vad7/Temperature_Display/Docs/Button 6x6 4P.png

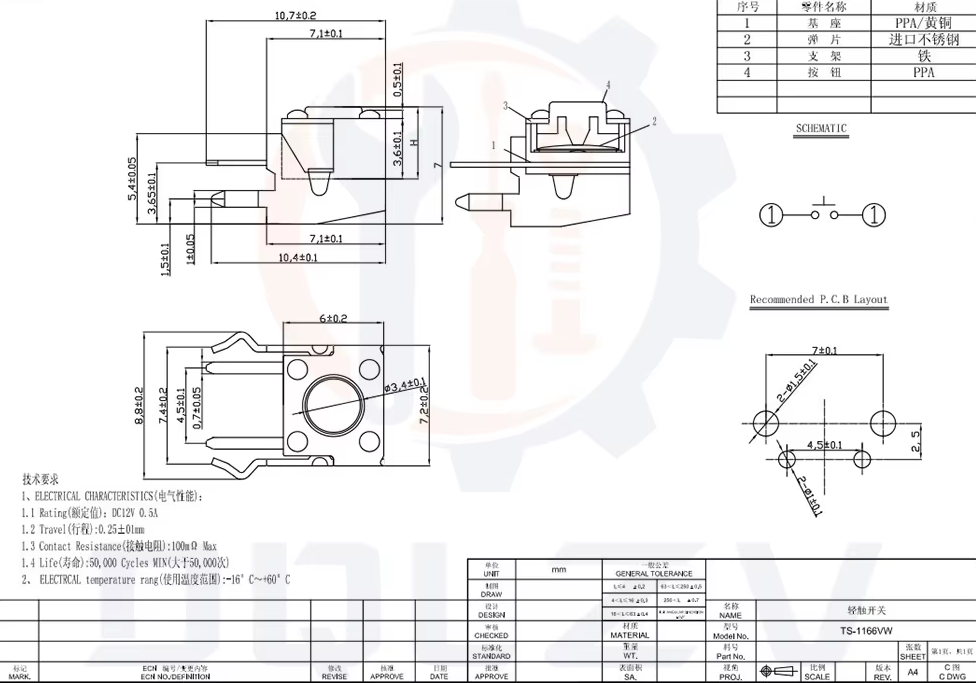
Docs/Button 6x6 4P.png
