vad7/Temperature_Display/Docs/Perfboard_20x80.png

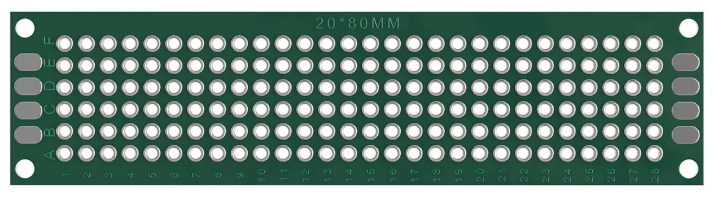
Docs/Perfboard_20x80.png
