vad7/Temperature_Display/Docs/Pro Mini 328 pinout.png

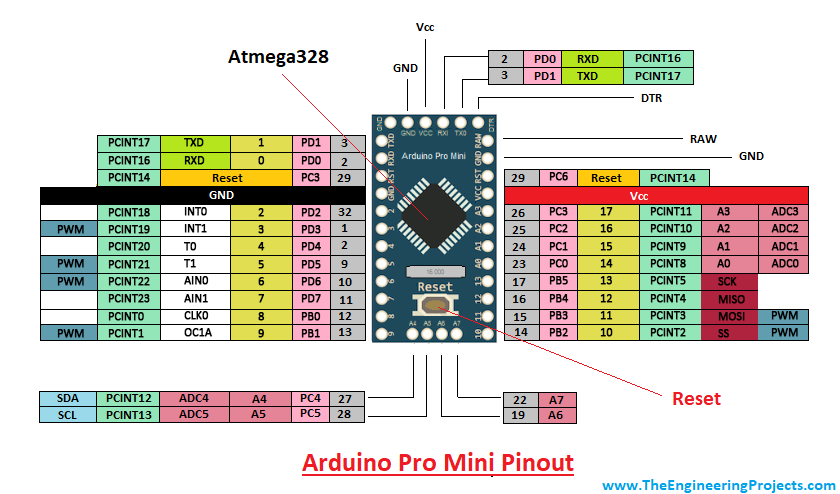
Docs/Pro Mini 328 pinout.png
