vad7/Temperature_Display/Docs/Pro Mini 328-2.png

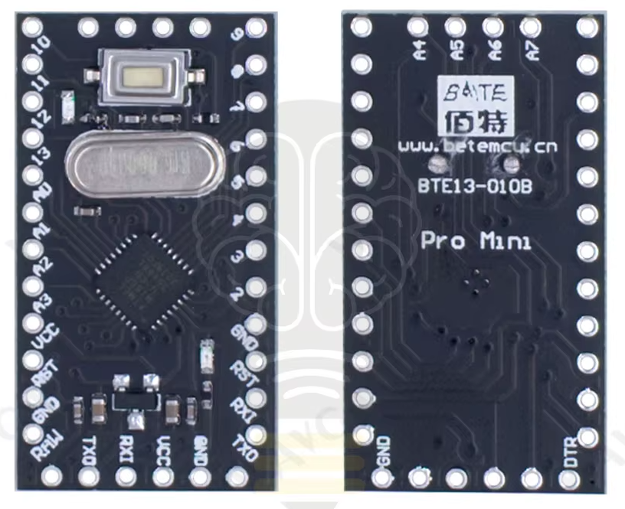
Docs/Pro Mini 328-2.png
