vad7/Temperature_Display/Docs/Pro Mini 328-3.png

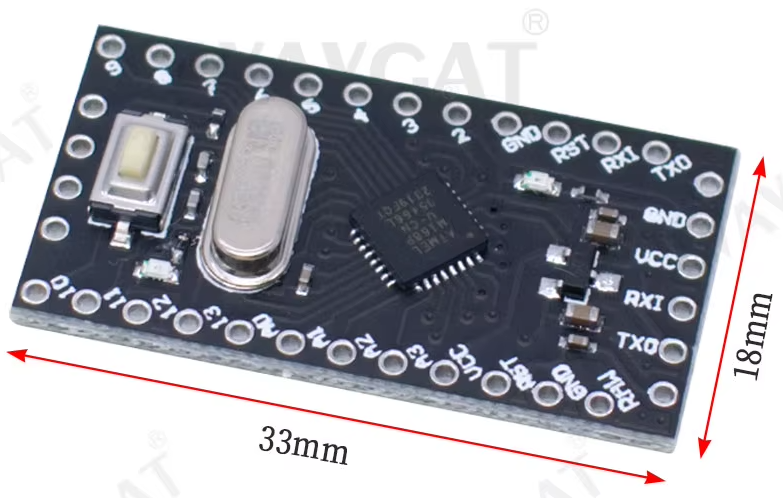
Docs/Pro Mini 328-3.png
