vad7/Temperature_Display/Docs/Pro Mini 328.png

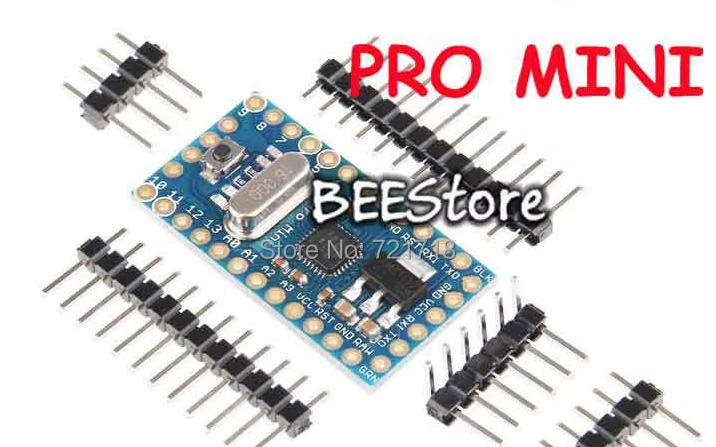
Docs/Pro Mini 328.png
