vad7/Temperature_Display/Docs/TFT1.77 128x160 ST7735S.png

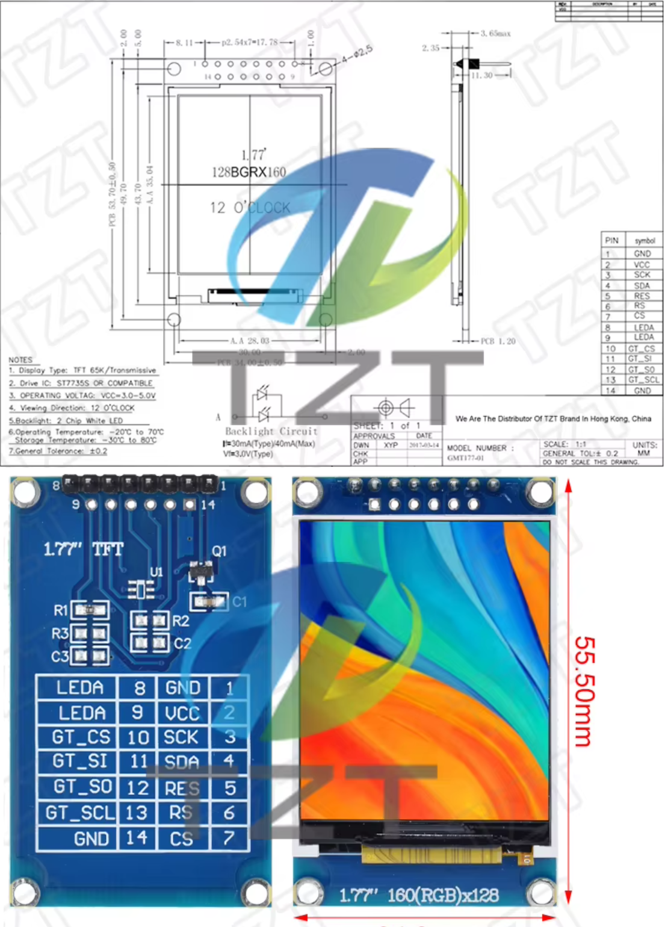
Docs/TFT1.77 128x160 ST7735S.png
