vad7/Temperature_Display/Build/enclosure/TempDisplay_tft24_assembly.step

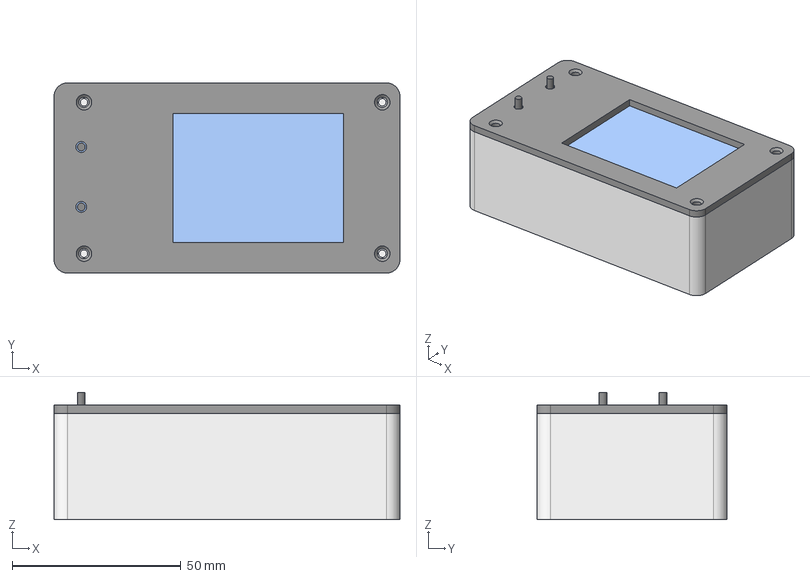
[picture p17: CAD file, 2026-11-03]
Build/enclosure/TempDisplay_tft24_assembly.step
102.6 x 56.4 x 37.7 mm
lid
bar_hlk_nano
ear_hlk_2
ear_promini_1
ear_promini_2
tft_glass
tft_pcb
perfboard
perfboard_c1
hlk
promini
button_1
button_2
button_1_plunger
button_2_plunger
