vad7/Temperature_Display/Build/enclosure/TempDisplay_tft18_assembly.step

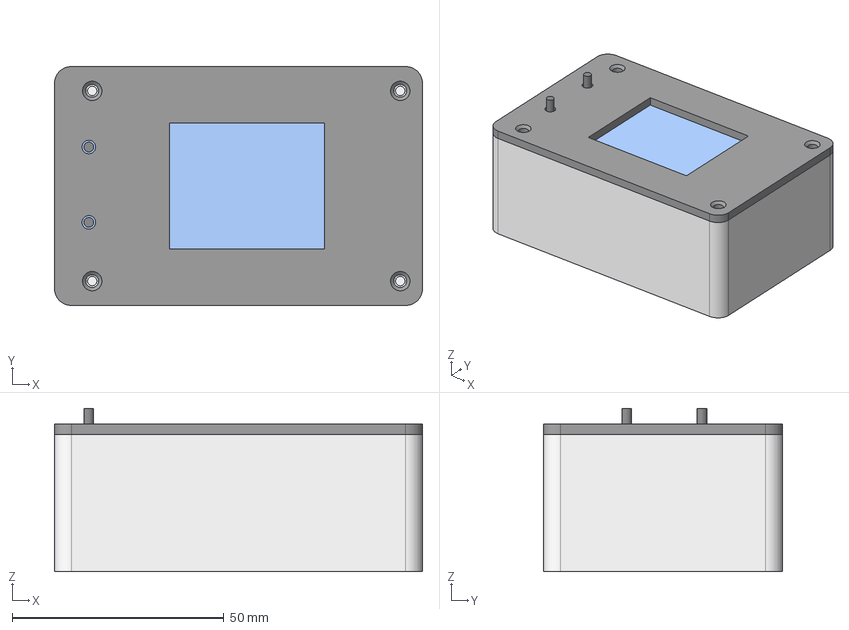
[picture p18: CAD file, 2026-11-03]
Build/enclosure/TempDisplay_tft18_assembly.step
86.8 x 56.4 x 38.5 mm
lid
bar_hlk_nano
ear_hlk_2
ear_promini_1
ear_promini_2
tft_glass
tft_pcb
perfboard
perfboard_c1
hlk
promini
button_1
button_2
button_1_plunger
button_2_plunger
