vad7/Temperature_Display/Build/enclosure/TempDisplay_tft177_body.stl

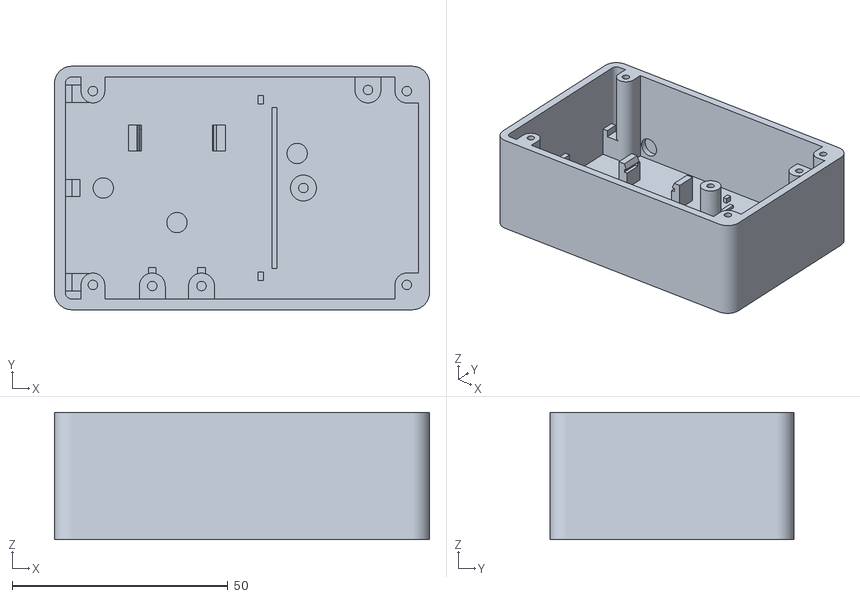
[picture p20: CAD file, 2026-11-03]
Build/enclosure/TempDisplay_tft177_body.stl
86.8 x 56.4 x 29.5
