vad7/Temperature_Display/Build/enclosure/TempDisplay_tft177_lid.stl

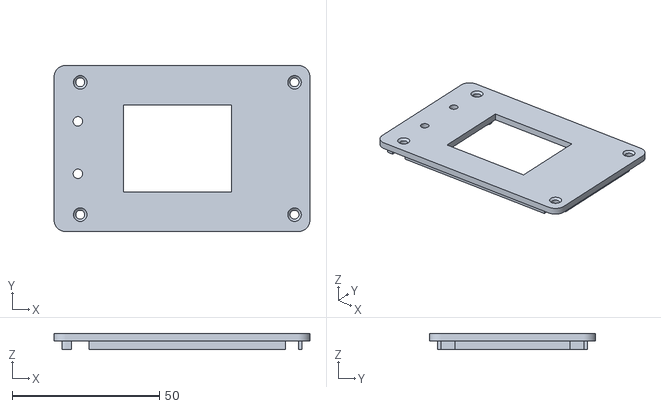
[picture p21: CAD file, 2026-11-03]
Build/enclosure/TempDisplay_tft177_lid.stl
86.8 x 56.4 x 5.50
