vad7/Temperature_Display/Build/enclosure/TempDisplay_tft24_lid.stl

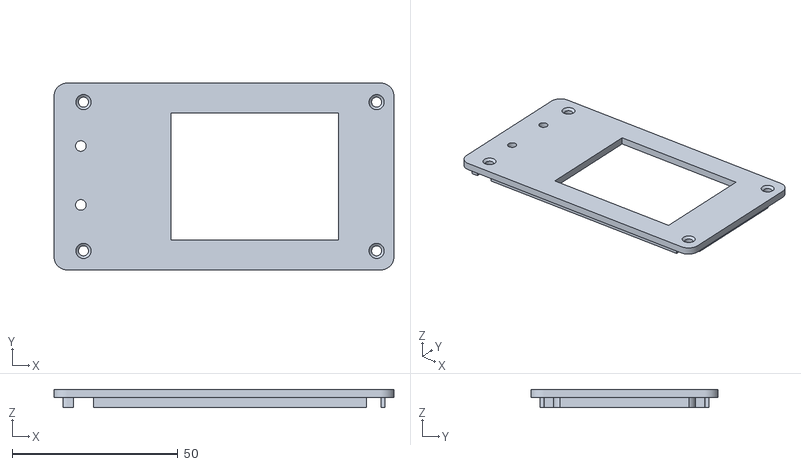
[picture p22: CAD file, 2026-11-03]
Build/enclosure/TempDisplay_tft24_lid.stl
102.6 x 56.4 x 5.50
