vad7/Temperature_Display/Build/enclosure/TempDisplay_tft18_lid.stl

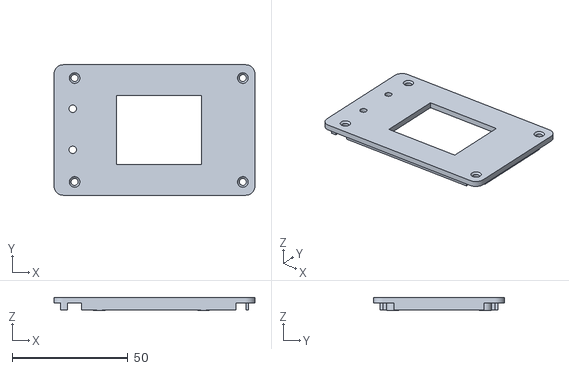
[picture p23: CAD file, 2026-11-03]
Build/enclosure/TempDisplay_tft18_lid.stl
86.8 x 56.4 x 5.65
