vad7/Temperature_Display/Build/enclosure/TempDisplay_tft24_body.stl

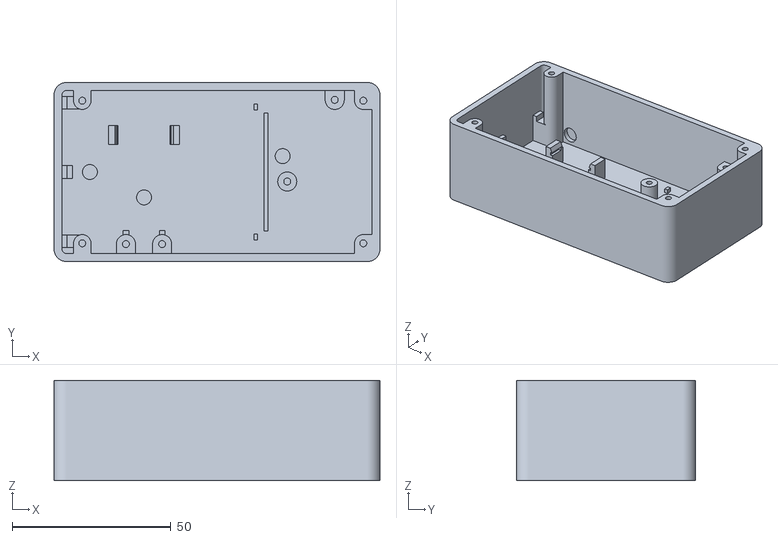
[picture p24: CAD file, 2026-11-03]
Build/enclosure/TempDisplay_tft24_body.stl
102.6 x 56.4 x 31.5
