vad7/Temperature_Display/Build/enclosure/TempDisplay_tft18_body.stl

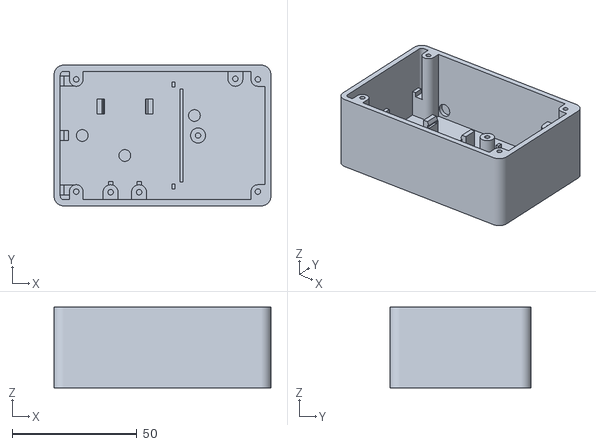
[picture p25: CAD file, 2026-11-03]
Build/enclosure/TempDisplay_tft18_body.stl
86.8 x 56.4 x 32.3
