vad7/Temperature_Display/Build/enclosure/TempDisplay_tft24_ears.stl

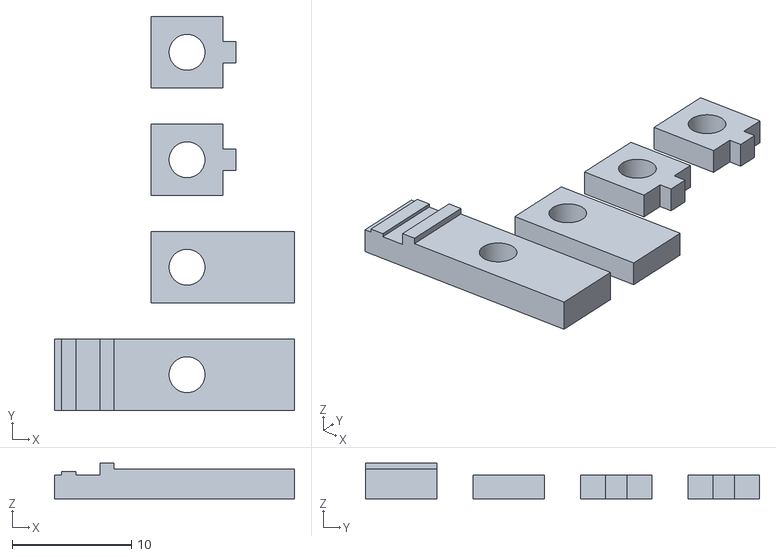
[picture p26: CAD file, 2026-10-23]
Build/enclosure/TempDisplay_tft24_ears.stl
20.1 x 33.0 x 3.00
