vad7/Temperature_Display/(list of files, cad)

Other CAD files:
Build/enclosure/TempDisplay_tft18_ears.stl
Build/enclosure/TempDisplay_tft177_ears.stl
