vad7/Temperature_Display/Build/enclosure/TempDisplay_tft18_preview.png

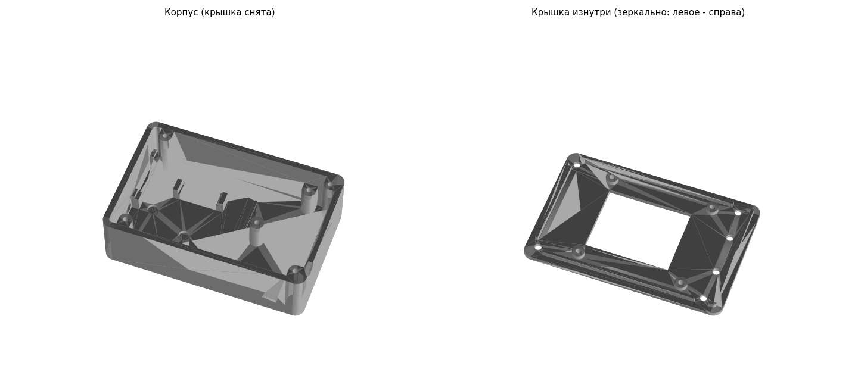
Build/enclosure/TempDisplay_tft18_preview.png
