vad7/Temperature_Display/Build/enclosure/TempDisplay_tft24_layout.png

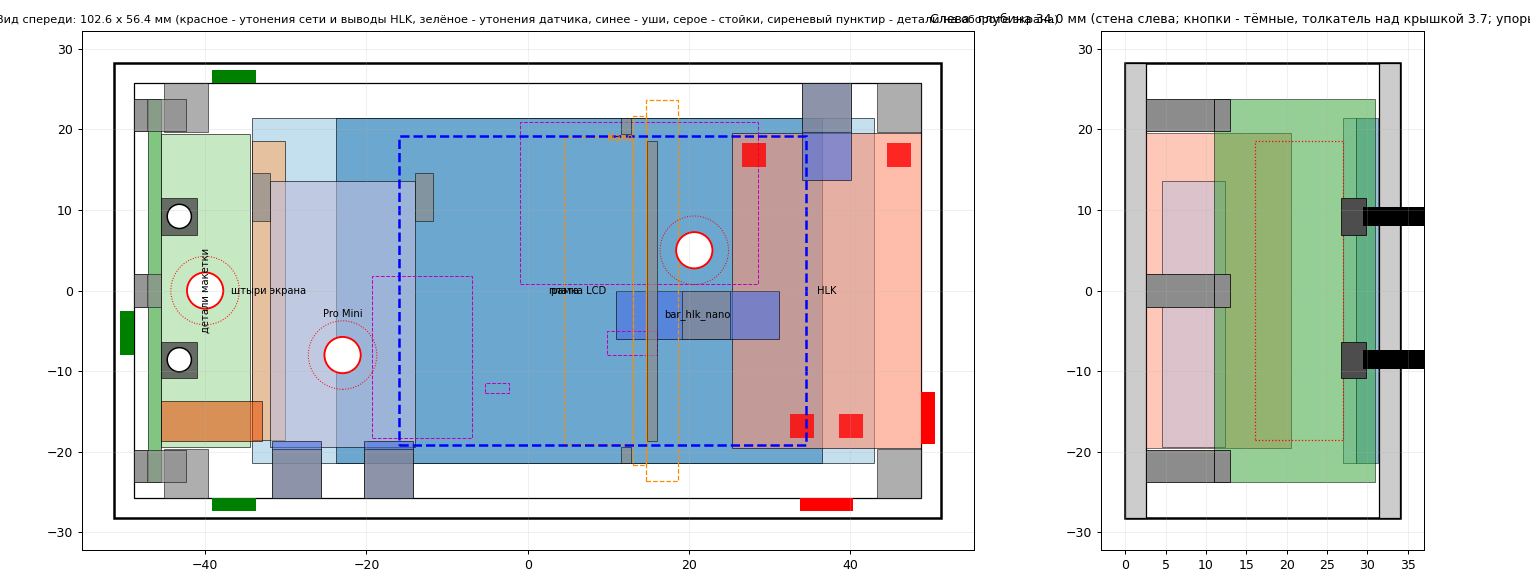
Build/enclosure/TempDisplay_tft24_layout.png
