vad7/Temperature_Display/Docs/3D Print settings.png

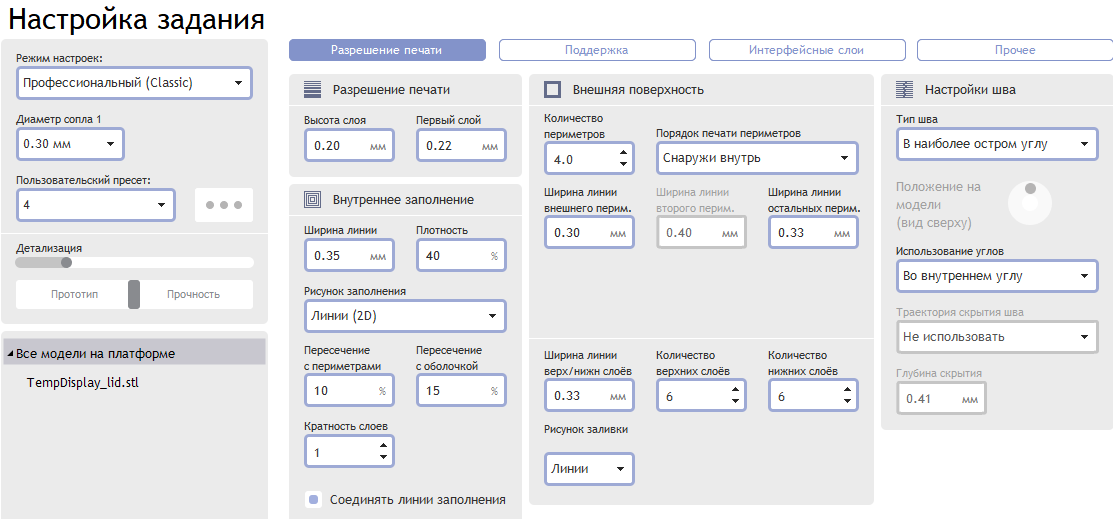
Docs/3D Print settings.png
