vad7/Temperature_Display/TempDisplay/include/history.h

// history.h - история температуры в ОЗУ: средние за TREND_SLOT_S (тенденция) и за GRAPH_SLOT_S (график),
// мин / макс измерений за каждые MINMAX_SLOT_S.
#pragma once
#include <stdint.h>

#define HIST_NONE  INT16_MIN      // в точке нет данных (датчика не было весь интервал)

struct Trend {
    bool    valid;     // данных хватает для стрелки (не меньше половины периода)
    int16_t deltaC100; // изменение за период, сотые °C
};

struct MinMax {
    bool    valid;     // есть хоть одно измерение
    int16_t minC10;
    int16_t maxC10;
};

namespace History {
void    add(int16_t c10);                     // очередное измерение
void    tick(uint32_t now);                   // закрывает интервалы по времени (в каждом проходе loop())
Trend   trend(uint8_t periodMin);             // тенденция за период
MinMax  minMax(uint8_t hours);                // мин / макс измерений за последние hours ч (hours - 1 полных + текущий)
bool    takeGraphChanged();                   // добавилась точка графика (флаг сбрасывается)
uint8_t graphCount();                         // точек графика (до GRAPH_SLOTS)
int16_t graphAt(uint8_t i);                   // i = 0 - самая старая, graphCount() - 1 - последняя
}
