vad7/Temperature_Display/(commit log)

2026-11-03 - другой вариант угловых кнопок - 6*6 - прошивка левых nano, макетная плата, счетчик ошибок датчиков - корректировка схемы - переворот экрана по 90 градусов, коррекция температуры, регулировка яркост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
    [TempDisplay_tft177_assembly.step, TempDisplay_tft177_body.stl, TempDisplay_tft177_lid.stl, TempDisplay_tft18_assembly.step, TempDisplay_tft18_body.stl, TempDisplay_tft18_lid.stl, TempDisplay_tft24_assembly.step, TempDisplay_tft24_body.stl]
2026-11-05 - увеличение размеров цифр мин/макс, архив с прошивальщиком без сред разработки
